jamespilgrim/Pi-Camera-Mounts/Pi Camera Mount - Slicer Output.png

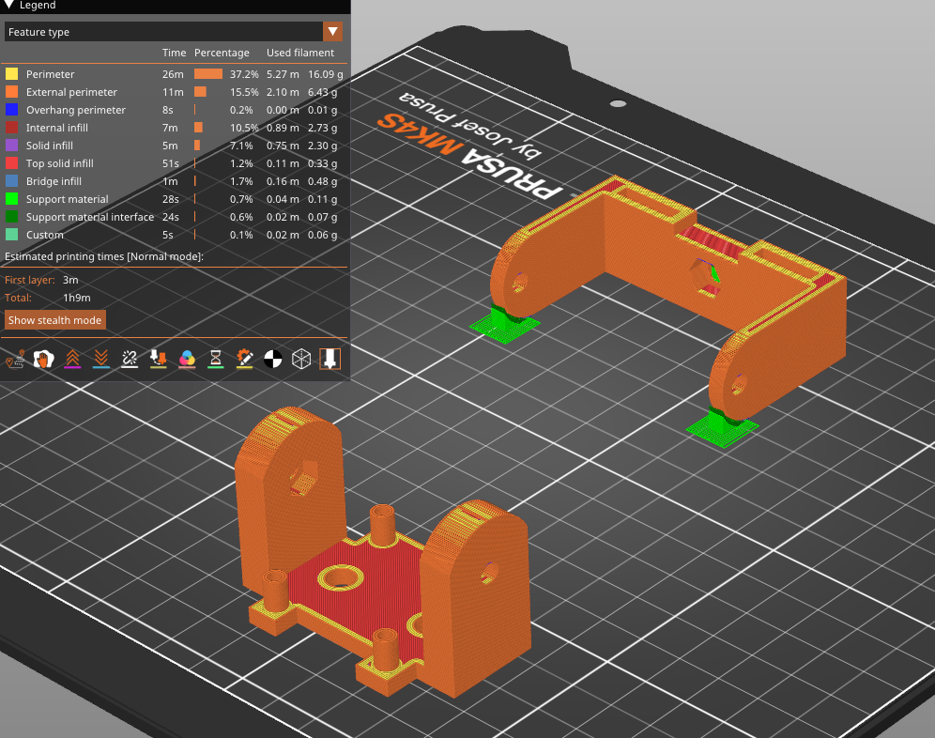
Pi Camera Mount - Slicer Output.png
