jamespilgrim/Pi-Camera-Mounts/Pi Camera Mount - 3D Model.png

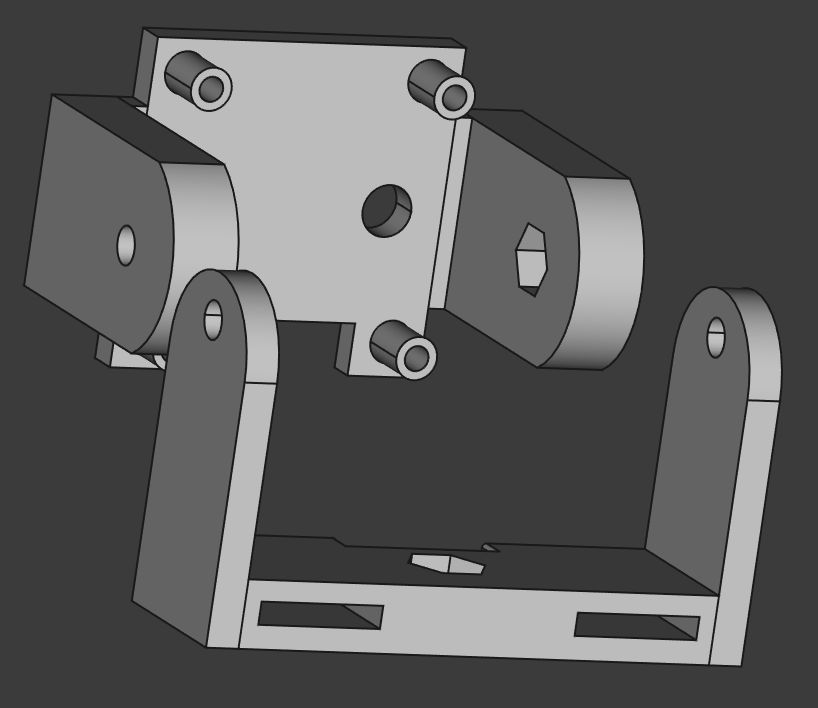
Pi Camera Mount - 3D Model.png
