jamespilgrim/Pi-Camera-Mounts/Camera Mount - Bottom Variation.3mf

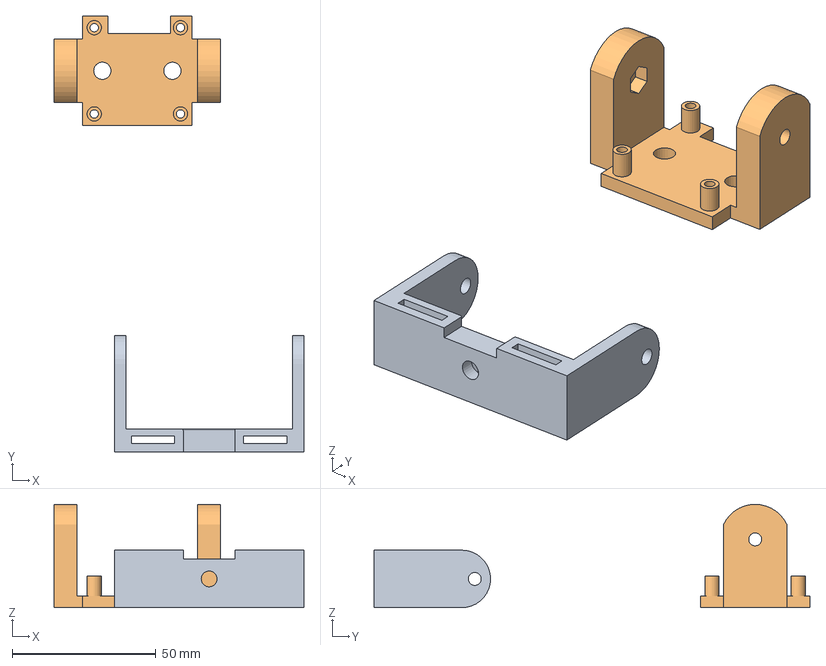
[picture p3: CAD file, 2024-11-26]
Camera Mount - Bottom Variation.3mf
87.0 x 151.5 x 35.9 mm
Camera Mount - Bottom Variation.stl_1
Camera Mount - Bottom Variation.stl_2
