jamespilgrim/Pi-Camera-Mounts/Camera Mount - Bottom.FCStd

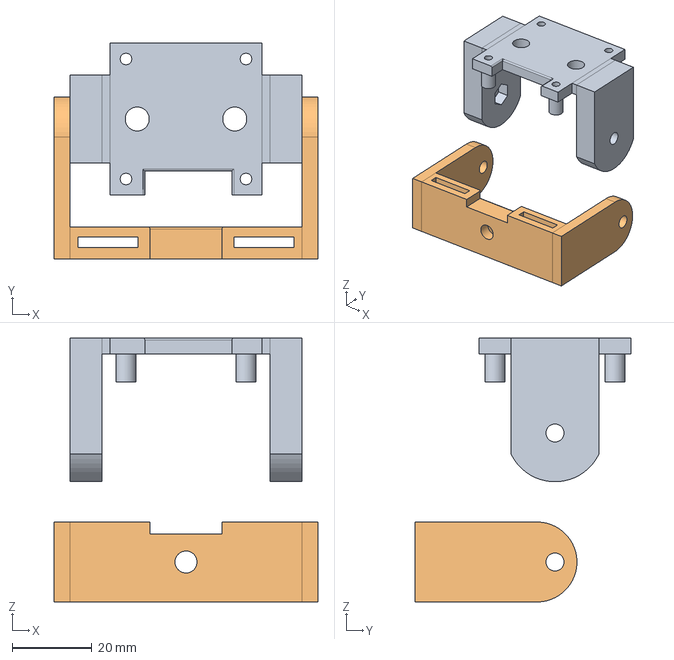
[picture p4: CAD file, 2024-11-26]
Camera Mount - Bottom.FCStd
66.0 x 54.0 x 66.0 mm
Back Plate Body
Gimbal Base Body
