jamespilgrim/Pi-Camera-Mounts/(list of files, cad)

Other CAD files:
Master Document.FCStd
Camera Mount - Bottom Variation.stl
